agutikov/yadr/scad/servo_mount.scad

include <servo_mount_module.scad>;

servo_mount();
