agutikov/yadr/(commit log)

2014-04-23 hardware: mechanics: affector prototype with prameters
    [affector.scad]
2014-04-23 comments for scad code
    [affector.scad]
2014-04-23 model for servo mount
    [servo_mount.scad]
2014-04-23 effector, not affector
    [effector.scad]
2014-04-24 effector and delta_mount complete, servo_mount need resize
    [delta_mount.scad, delta_mount_module.scad, effector.scad, servo_mount.scad]
2014-04-24 stl models for printing
    [delta_mount.stl, effector.stl]
2014-04-26 delta mount and effector complete
    [delta_mount.scad, delta_mount.stl, delta_mount_module.scad, effector.scad, effector.stl, lib.scad, servo_mount.scad]
2014-04-28 Add servo mount.
    [servo_mount.scad, servo_mount.stl]
2014-05-20 automatic exporting stl
    [delta_mount.stl, servo_mount.stl]
2014-05-25 calculating delta kinematics
2014-05-25 firmware template for stm32vl-discovery
2014-06-04 Added printing delta base to A4 postscript.
    Removed stl files - build them with make.
    [base.scad, delta_mount.stl, effector.stl, servo_mount.scad, servo_mount.stl, servo_mount_module.scad]
2014-06-05 Added lines for servo arms onto base graphics.
    [base.scad]
2014-06-09 Fix sizes for base picture.
    [base.scad]
2014-06-09 usart (rx-interrupt, tx-poll) works
2014-06-09 usart (rx,tx interrupt) works
2014-06-09 terminal driver modifications
2014-06-09 stm32 has no eeprom
2014-06-10 servo test
2014-06-10 pass arch-dependant flags to linker, otherwise it will link arm-code (not thumb) from newlib
2014-06-15 [arduino-uno] servo with serial sample added
2014-06-19 [arduino] serial_driver.ino added - allows to set servos using xxaxxbxxc-like string via serial
2014-07-12 fix bug with jumping to zero point
    [delta_mouse.py]
2014-07-16 strtol for stm32
2014-07-16 int to string, blink on set pwm command
2014-07-17 do not calculate workarea
    until havn't got mathematics to do it correct
    [delta_mouse.py]
2014-07-17 use stm32 as controller
2014-07-17 invert z-axis for mouse wheel
    [delta_mouse.py]
2014-07-17 send and recv pwm command correctly
    [delta_mouse.py, main.c]
2014-07-19 blinking on pwm
2014-07-29 mount for finger holder
    [config.scad, delta_mount.scad, delta_mount_module.scad, effector.scad, finger_fixator.scad, finger_mount.scad, lib.scad]
